bjohan/CorboLight/sch/sch.kicad_pcb

## KiCad design sch/sch.kicad_pcb (2016-09-04)

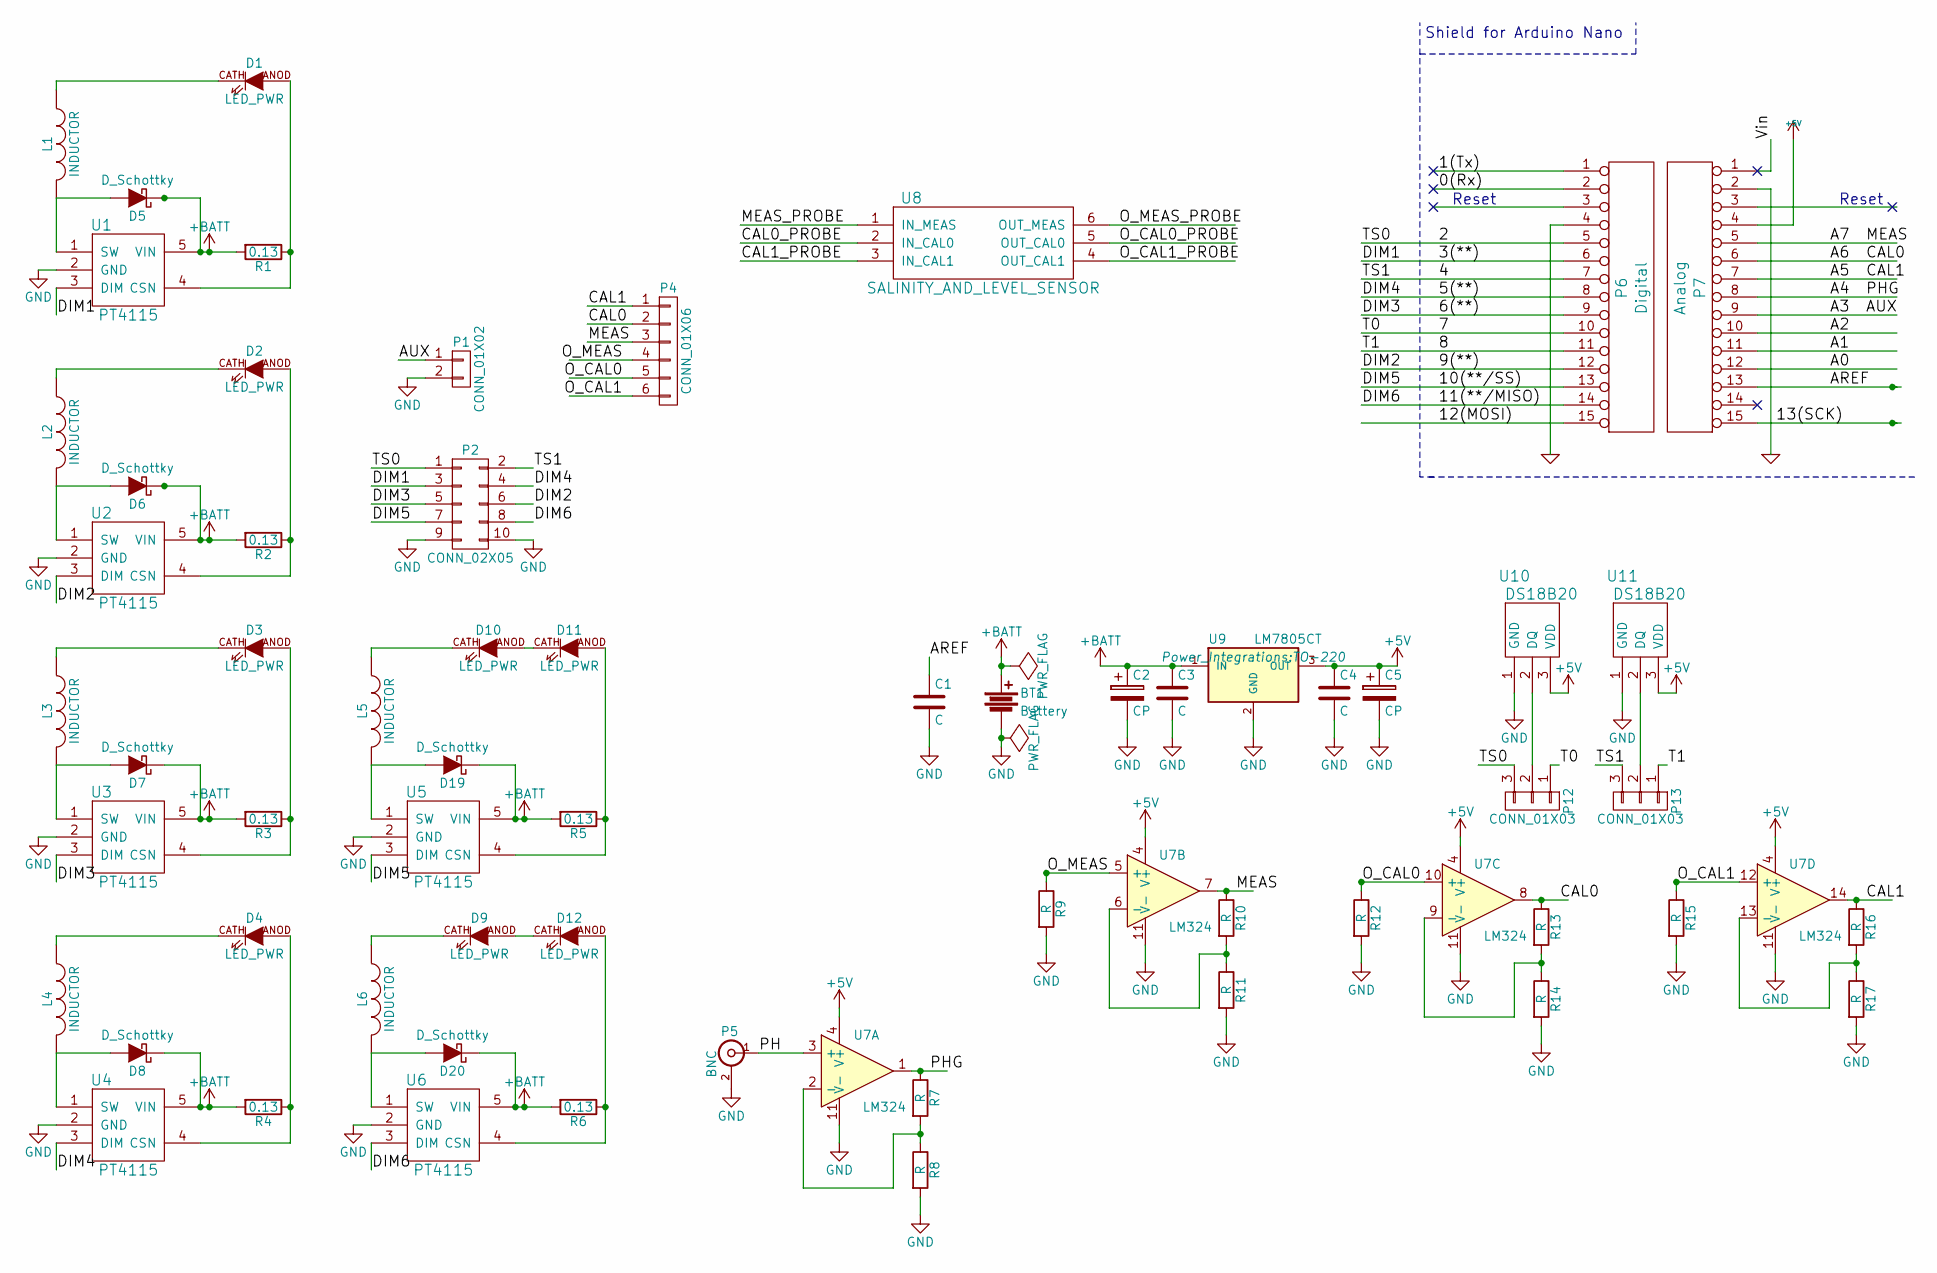
[picture p1: schematic sch.sch]

Parts:
BT1: Battery; bornier2
C1, C3, C4: C; C_1206_HandSoldering
C2, C5: CP; C_Radial_D5_L6_P2.5
D1, D2, D3, D4, D9, D10, D11, D12: LED_PWR; lumiled-2-LAMBERTIAN
D5, D6, D7, D8, D19, D20: D_Schottky; DO-214AB_Handsoldering
L1, L2, L3, L4, L5, L6: INDUCTOR; Neosid_Inductor_Ms95
P1: CONN_01X02; PINHEAD1-2
P2: CONN_02X05; IDC_Header_Straight_10pins
P4: CONN_01X06; PINHEAD1-6
P5: BNC; bnc-ci
P6: Digital; Socket_Strip_Arduino_1x15
P7: Analog; Socket_Strip_Arduino_1x15
P12, P13: CONN_01X03; PINHEAD1-3
R1, R2, R3, R4, R5, R6: 0.13; R_1206_HandSoldering
R7, R8, R9, R10, R11, R12, R13, R14, R15, R16, R17: R; R_0805_HandSoldering
U1, U2, U3, U4, U5, U6: PT4115; SOT89-5_Housing_Handsoldering
U7: LM324; SOIC-14_N
U8: SALINITY_AND_LEVEL_SENSOR
U9: LM7805CT; TO-220
U10, U11: DS18B20; TO-92_Inline_Narrow_Oval

Connections:
+5V: C4.1, C5.1, P7.4, U7.4 (V+), U9.3 (OUT), U10.3 (VDD), U11.3 (VDD)
+BATT: BT1.1, C2.1, C3.1, D5.1 (K), D6.1 (K), D7.1 (K), D8.1 (K), D19.1 (K), D20.1 (K), R1.2, R2.2, R3.2, R4.2, R5.2, R6.2, U1.5 (VIN), U2.5 (VIN), U3.5 (VIN), U4.5 (VIN), U5.5 (VIN), U6.5 (VIN), U9.1 (IN)
/0(Rx): P6.2
/1(Tx): P6.1
/2: P2.1, P6.5, P12.3
/3(**): P2.3, P6.6, U1.3 (DIM)
/4: P2.2, P6.7, P13.3
/5(**): P2.4, P6.8, U4.3 (DIM)
/6(**): P2.5, P6.9, U3.3 (DIM)
/7: P6.10, P12.1
/8: P6.11, P13.1
/9(**): P2.6, P6.12, U2.3 (DIM)
/10(**/SS): P2.7, P6.13, U5.3 (DIM)
/11(**/MISO): P2.8, P6.14, U6.3 (DIM)
/12(MOSI): P6.15 (p15)
/13(SCK): P7.15 (p15)
/A0: P7.12
/A1: P7.11
/A2: P7.10
/A3: P1.1, P7.9
/A4: P7.8, R7.1, U7.1
/A5: P4.1, P7.7, R16.1, U7.14
/A6: P4.2, P7.6, R13.1, U7.8
/A7: P4.3, P7.5, R10.1, U7.7
/AREF: C1.1, P7.13
/O_CAL0: P4.5, R12.1, U7.10 (+)
/O_CAL1: P4.6, R15.1, U7.12 (+)
/O_MEAS: P4.4, R9.1, U7.5 (+)
/PH: P5.1 (In), U7.3 (+)
/Vin: P7.1
GND: BT1.2, C1.2, C2.2, C3.2, C4.2, C5.2, P1.2, P2.9, P2.10, P5.2 (Ext), P6.4, P7.2, R8.2, R9.2, R11.2, R12.2, R14.2, R15.2, R17.2, U1.2 (GND), U2.2 (GND), U3.2 (GND), U4.2 (GND), U5.2 (GND), U6.2 (GND), U7.11 (V-), U9.2 (GND), U10.1 (GND), U11.1 (GND)
unnamed: D1.ANOD (A), R1.1, U1.4 (CSN)
unnamed: D1.CATH (C), L1.1
unnamed: D2.ANOD (A), R2.1, U2.4 (CSN)
unnamed: D2.CATH (C), L2.1
unnamed: D3.ANOD (A), R3.1, U3.4 (CSN)
unnamed: D3.CATH (C), L3.1
unnamed: D4.ANOD (A), R4.1, U4.4 (CSN)
unnamed: D4.CATH (C), L4.1
unnamed: D5.2 (A), L1.2, U1.1 (SW)
unnamed: D6.2 (A), L2.2, U2.1 (SW)
unnamed: D7.2 (A), L3.2, U3.1 (SW)
unnamed: D8.2 (A), L4.2, U4.1 (SW)
unnamed: D9.CATH (C), L6.1
unnamed: D10.ANOD (A), D11.CATH (C)
unnamed: D10.CATH (C), L5.1
unnamed: D11.ANOD (A), R5.1, U5.4 (CSN)
unnamed: D12.ANOD (A), R6.1, U6.4 (CSN)
unnamed: D9.ANOD (A), D12.CATH (C)
unnamed: D19.2 (A), L5.2, U5.1 (SW)
unnamed: D20.2 (A), L6.2, U6.1 (SW)
unnamed: P12.2, U10.2 (DQ)
unnamed: P13.2, U11.2 (DQ)
unnamed: R7.2, R8.1, U7.2 (-)
unnamed: R10.2, R11.1, U7.6 (-)
unnamed: R13.2, R14.1, U7.9 (-)
unnamed: R16.2, R17.1, U7.13 (-)

Notes on the sheet:
Shield for Arduino Nano
Reset

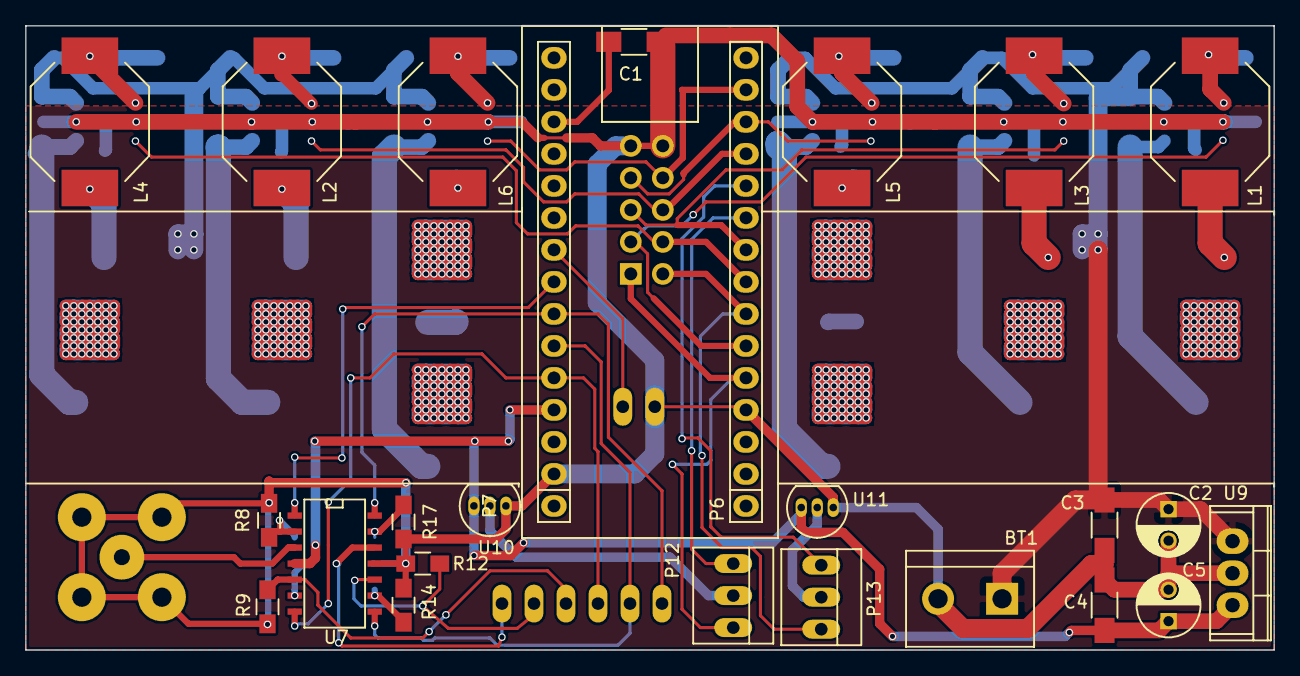
[picture p2: board sch.kicad_pcb from above]

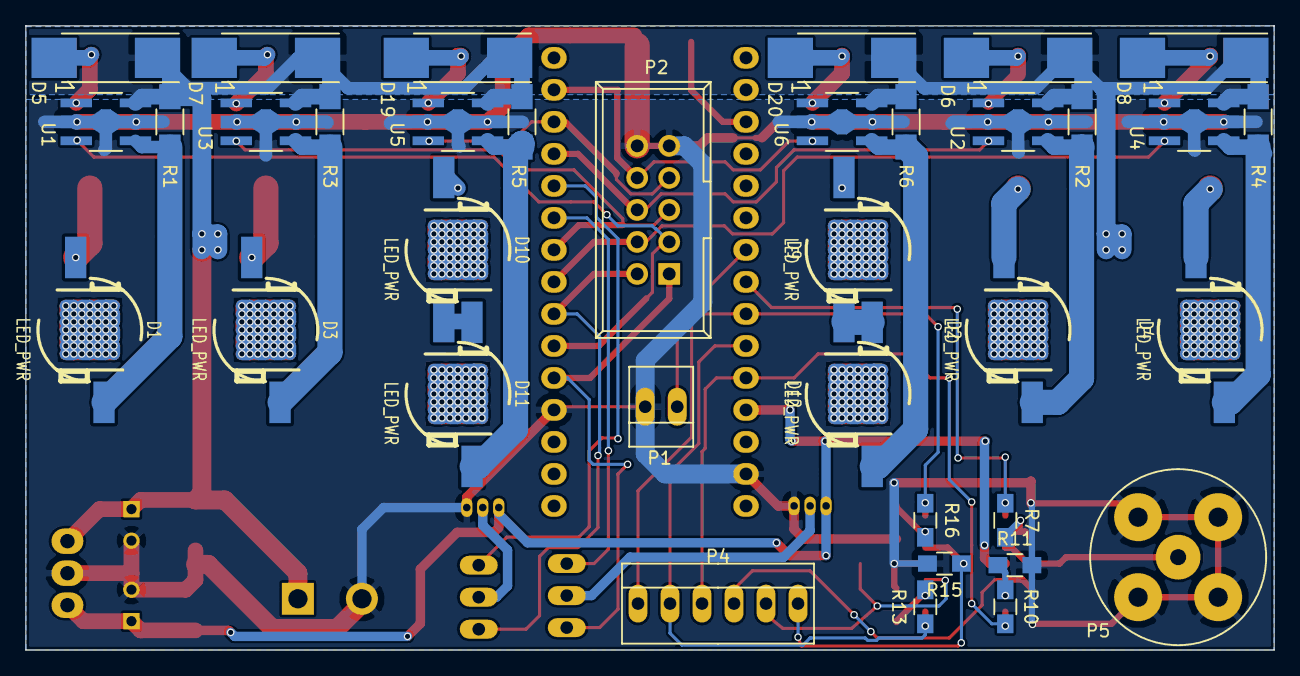
[picture p3: board sch.kicad_pcb from below]

Board: 2 copper layers, 99.1 x 49.5 mm, 61 parts (36 on the bottom side), 49 nets.
