bjohan/CorboLight/(commit log)

2016-07-23 Started kicad project
    [sch.kicad_pcb, sch.sch]
2016-07-23 Started schematic draft
    [sch.sch]
2016-07-23 More schematic work
    [sch.sch]
2016-07-24 Finished drafting and started correcting DRC
    [sch.sch]
2016-07-24 Schematic ready for layout, started layout work
    [sch.kicad_pcb, sch.sch]
2016-07-26 Started placement
    [sch.kicad_pcb, sch.sch]
2016-07-27 Added some footprint libraries and started layout
    [sch.kicad_pcb, sch.sch]
2016-08-15 continued routing
    [sch.kicad_pcb, sch.sch]
2016-08-16 Changed some connections to make layout easier
    [sch.kicad_pcb, sch.sch]
2016-08-17 Initial version done
    [sch.kicad_pcb, sch.sch]
2016-08-17 Some minor fixes
    [sch.kicad_pcb]
2016-09-03 Fixed silkscreen and moved bnc connector so that silkscreen is on the board
    [sch.kicad_pcb]
2016-09-04 Fixed minor details in pcb and added openings in solder mas for thermal vias behind led
    [CorboLight.GBL, CorboLight.GBO, CorboLight.GBS, CorboLight.GTL, CorboLight.GTO, CorboLight.GTS, sch-B.Cu.gbl, sch-B.Mask.gbs]
2016-09-23 Simple firmware to dim leds
2016-10-08 Added first version of housing
    [Housing.scad]
2016-11-30 Added load and save funktions for led power levels
2016-12-11 Added fixed bug introduced earlier some time with caching values. Also tested ph probe
    [LightSketch.ino]
2016-12-15 Experiments with printing
    [Housing.scad]
2016-12-25 started work on pcb mounting
    [Housing.scad]
2016-12-25 Added clamps for pcb
    [Housing.scad]
2016-12-25 Added holes for mounting
    [Housing.scad]
